QuangHop-dev/MiniSoC_integrated_Kyber_cryptographic_Accelerator/docs/Poster_DoAn.pdf

Work | Mode | Area | Freq. [MHz] | Key/Enc/Dec Time [us] | ADP [x10⁶ ]
LUT | FF | BRAM | DSP | ENS
[1] | Enc. | 80K | - | 200.5 | 54 | 158K | 155 | - / 316 / 444 | - /21/43.3
| Dec. | 202k | - | 202 | 354 | 217K
[2] | Enc. | 4.8K | 3K | 2.5 | 0 | 1885 | 244 | 278/ 416/ 552 | 0.54/ 0.78 /1.07
| Key.& Dec. | 4.9K | 3K | 2.5 | 0 | 1942
[3] | Key.& Enc.& Dec. | 5K | 2K | 6.5 | 2 | 2791 | 258 | 4593/ 4944/ 4691 | 12.8/ 13.8 /13.1
[4] | | 18K | 5K | 15 | 6 | 8540 | 115 | 34.8/ 60.9/ 86.9 | 0.30/ 0.52 /0.74
This Work | | 19K | 8K | 5 | 0 | 7321 | 167 | 46.7 / 60.1 / 82.4 | 0.34/ 0.44 /0.60

## 2. MỤC TIÊU & CƠ SỞ

# THIẾT KẾ VÀ ĐÁNH GIÁ PHẦN CỨNG TĂNG TỐC THUẬT TOÁN MẬT MÃ HẬU LƯỢNG TỬ CRYSTALS-KYBER TÍCH HỢP

# TRÊN VI ĐIỀU KHIỂN LÕI RISC-V

1. TÓM TẮT / ĐẶT VẤN ĐỀ | 5. KIỂM CHỨNG & KẾT QUẢ THỰC NGHIỆM

## 4. KIẾN TRÚC BỘ TĂNG TỐC CRYSTALS-KYBER

Module Simulation

## 6. KẾT LUẬN & HƯỚNG PHÁT TRIỂN

Controller

Comparator

Hash Unit Buffer Input | Buffer Output
Keccak
State

Keccak-f1600

θ | ρ | π | X

seed

rd/we

verify

start

done

mode

busy

din
ready

dout
addr

Memory Bank

Single Port RAM 0

Single Port RAM 1

Single Port RAM 2

Compress

Compress_u10

Compress_v4

Decompress

Decompress_u10

Decompress_v4

ROM Zeta

Barrett
Reduce

Barrett
Reduce

RAM0

RAM1

Basemul

Pointwise Multiply Accumulate

Sampling Unit

Matrix Sampler

CBD Sampler

Single Port RAM 3

Decode

Decode1

Decode12

Encode1

Encode12

Encode

Dual Port
RAM

Single Port
RAM

Unified
Add/sub

Unified
Add/sub

Unified Add/Sub mod q

H(pk),
ss

c1,
c2

c1,
c2

c1,
c2

seed

H(c),
H(c

digest

Dual Port
RAM 0

Dual Port
RAM 1

BFU

ROM Twidle

ADD_GEN | Control Unit

NTT/INTT

| s, e, r

t^, s^

A,
AT

m1

t'

e1, e2

pko, mo | mo

rho,
sigma,
K, rc | A, AT ski , pki , mi

sko,
pko,
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
r^, s^, e^

u

v

u,
v
Module độc lập mỗi chế độ riêng biệt | Module chia sẻ dùng chung cho ba chế độ

### Chú thích tên các khối

## 9. TÀI LIỆU THAM KHẢO

[1] Wu-Yiming-Huang, Miaoqing-Huang, Zhongkui-Lei and Jiaxuan, "A Pure Hardware Implementation of CRYSTALS-KYBER PQC Algorithm through Resource Reuse," IEICE Electronics Express, vol. advpub, p. 17.2020023, 2020.
[2] He-Ma-Shiyang, Hui-Li, Fenghua-Li and Ruhui, "A lightweight hardware implementation of CRYSTALS-Kyber," Journal of Information and Intelligence, vol. 2, no. 2, 949-7159, p. 2, 2024.
[3] Arpan-Jati, Naina-Gupta, Anupam-Chattopadhyay and Kumar-Sanadhya-Somitra, "A Configurable CRYSTALS-Kyber Hardware Implementation with Side-Channel Protection," ACM Trans. Embed. Comput. Syst., vol. 23, no. 1539-9087.
[4] Bisheh-Niasar-Mojtaba, Azarderakhsh-Reza and Mozaffari-Kermani-Mehran, "Instruction-Set Accelerated Implementation of CRYSTALS-Kyber,

" IEEE Transactions on Circuits and Systems I: Regular Papers, vol. 68, no. 11, pp. 4648-4659, 2021.

- Sự phát triển của máy tính lượng tử đang đe doạ các hệ mật mã công khai truyền thống như RSA hay ECC.
- CRYSTALS-Kyber là thuật toán cho trao đổi khoá bí mật đã được NIST chuẩn hoá và đang được cộng đồng học thuật liên tục tối ưu và hiện thực phần cứng
- Cần một kiến trúc phần cứng có hiệu năng cao, nhưng tiêu thụ tài nguyên hợp lý và phù hợp cho hệ thống nhúng.

Dựa trên thuật toán CRYSTALS-Kyber (ML-KEM).
Dựa trên toán học Mạng lưới (Lattice-based) và bài toán MLWE trên vành đa thức đồng dư.
Kiến thức về vi điều khiển và hệ nhúng.

## 3. KIẾN TRÚC VI ĐIỀU KHIỂN

Model C | Full SoC Simulation | FPGA Validation

QUY TRÌNH KIỂM CHỨNG

THỰC NGHIỆM TRÊN FPGA ZCU102

KeyGen | Decaps
- Chu kỳ: 7.785
- Kết quả khớp C-REF
- Chu kỳ: 10.025
- Kết quả khớp C-REF
- Chu kỳ: 13.743
- Kết quả khớp C-REF

Encaps

## Wishbone Bus

### RISC-V RV32I

IMEM (16KB)
0x00000-0x0FFFF

SRAM (16KB)
0x10000-0x1FFFF

TIMER
0x60000-0x6FFFF

I2C
0x40000-0x4FFFF

### UART

0x70000-0x7FFFF

GPIO0 / GPIO1
0x20000-0x2FFFF
0x30000-0x3FFFF

### Kyber Accelerator

0x80000-0x8FFFF

Interrupt Controller
0x50000-0x5FFFF

Interrupt
Event

### CƠ SỞ LÝ THUYẾT

### MỤC TIÊU

Thiết kế bộ tăng tốc có khả năng chia sẻ module và thực hiện các chế độ trên 1 phần cứng duy nhất.

Tích hợp bộ tăng tốc vào hệ thống vi điều khiển dùng CPU RISC-V RV32I.

Kiểm chứng bằng mô hình tham chiếu C, mô phỏng và thực nghiệm FPGA.

Hash Unit: băm dữ liệu.

Sampling Unit: sinh ma
trận và vector (CBD).

NTT/INTT: biến đổi số học.

PWMA: nhân-tích điểm.

Unified Add/Sub:
cộng/trừ modulo q.

Compress/Decompress/
Encode/Decode: nén, giải
nén, mã hoá, giải mã.

Comparator: so sánh kết
quả mã hoá lại ở Decaps.

TRƯỜNG ĐẠI HỌC CÔNG NGHỆ KỸ THUẬT

THÀNH PHỐ HỒ CHÍ MINH

KHOA ĐIỆN – ĐIỆN TỬ

BỘ MÔN KỸ THUẬT MÁY TÍNH – VIỄN THÔNG

# THIẾT KẾ VÀ ĐÁNH GIÁ PHẦN CỨNG TĂNG TỐC THUẬT TOÁN MẬT MÃ HẬU LƯỢNG TỬ CRYSTALS-KYBER TÍCH HỢP

# TRÊN VI ĐIỀU KHIỂN LÕI RISC-V

### GVHD:

### PGS.TS. Đỗ Duy Tân

### SVTH:

Phạm Quang Hợp | – 22119178
Đặng Vĩnh Tiến | – 22119239

Đã thiết kế và tích hợp được bộ tăng tốc CRYSTALS-Kyber vào hệ thống vi điều khiển và demo thành công trên FPGA.

Kết quả kiểm chứng cho thấy đầu ra khớp với kết quả từ phần mềm tham chiếu qua Known-Answer-Test (KAT).

Bảng so sánh kết quả đề tài với các nghiên cứu khác

Cơ bản, bộ tăng tốc đạt được sự cân bằng giữa hiệu năng và tài nguyên, vượt qua một số đề tài cùng cách tiếp cận khác.

### Hướng phát triển

- Tiếp tục tối ưu các khối lớn Hash Core, NTT giảm LUT/FF và tăng tần số hoạt động. Tích hợp khối TRNG để hoàn chỉnh bộ tăng tốc.
- Mở rộng môi trường kiểm thử với UVM, assertion để tự động bắt lỗi, và kiểm soát độ bao phủ code và chức năng phần cứng.
- Chuẩn hoá hệ thống theo FIPS-203, và mở rộng hỗ trợ hai mức bảo mật cao hơn ML-KEM-768 và 1024. Từ đó, tiến tới triển khai ASIC.

## 7. THÔNG SỐ HIỆN THỰC TRÊN FPGA

Fmax Implement

# 190 MHz

Tần số vận hành
chọn tại

# 167 MHz

Công suất toàn
hệ thống
1.326 W

WNS: 0.192 ns

WHS: 0.014 ns
