QuangHop-dev/MiniSoC_integrated_Kyber_cryptographic_Accelerator/kyber/ref/params.h

#ifndef PARAMS_H
#define PARAMS_H

#ifndef KYBER_K
#define KYBER_K 2	/* Kyber-512 default for this project */
#endif


/* Don't change parameters below this line */
#if   (KYBER_K == 2)
#define KYBER_NAMESPACE(s) pqcrystals_kyber512_ref_##s
#elif (KYBER_K == 3)
#define KYBER_NAMESPACE(s) pqcrystals_kyber768_ref_##s
#elif (KYBER_K == 4)
#define KYBER_NAMESPACE(s) pqcrystals_kyber1024_ref_##s
#else
#error "KYBER_K must be in {2,3,4}"
#endif

#define KYBER_N 256
#define KYBER_Q 3329

#define KYBER_SYMBYTES 32   /* size in bytes of hashes, and seeds */
#define KYBER_SSBYTES  32   /* size in bytes of shared key */

#define KYBER_POLYBYTES		384
#define KYBER_POLYVECBYTES	(KYBER_K * KYBER_POLYBYTES)

#if KYBER_K == 2
#define KYBER_ETA1 3
#define KYBER_POLYCOMPRESSEDBYTES    128
#define KYBER_POLYVECCOMPRESSEDBYTES (KYBER_K * 320)
#elif KYBER_K == 3
#define KYBER_ETA1 2
#define KYBER_POLYCOMPRESSEDBYTES    128
#define KYBER_POLYVECCOMPRESSEDBYTES (KYBER_K * 320)
#elif KYBER_K == 4
#define KYBER_ETA1 2
#define KYBER_POLYCOMPRESSEDBYTES    160
#define KYBER_POLYVECCOMPRESSEDBYTES (KYBER_K * 352)
#endif

#define KYBER_ETA2 2

#define KYBER_INDCPA_MSGBYTES       (KYBER_SYMBYTES)
#define KYBER_INDCPA_PUBLICKEYBYTES (KYBER_POLYVECBYTES + KYBER_SYMBYTES)
#define KYBER_INDCPA_SECRETKEYBYTES (KYBER_POLYVECBYTES)
#define KYBER_INDCPA_BYTES          (KYBER_POLYVECCOMPRESSEDBYTES + KYBER_POLYCOMPRESSEDBYTES)

#define KYBER_PUBLICKEYBYTES  (KYBER_INDCPA_PUBLICKEYBYTES)
/* 32 bytes of additional space to save H(pk) */
#define KYBER_SECRETKEYBYTES  (KYBER_INDCPA_SECRETKEYBYTES + KYBER_INDCPA_PUBLICKEYBYTES + 2*KYBER_SYMBYTES)
#define KYBER_CIPHERTEXTBYTES (KYBER_INDCPA_BYTES)

#endif
