QuangHop-dev/MiniSoC_integrated_Kyber_cryptographic_Accelerator/rtl/kyber/kyber_twiddle_rom.v

`timescale 1ns/1ps

// -----------------------------------------------------------------------------
// kyber_twiddle_rom
// Kyber512 RTL source. Comments and unused debug-only code were removed for a
// synthesis-oriented release build.
// -----------------------------------------------------------------------------

module kyber_twiddle_rom #(
    parameter USE_PWMA = 1'b0
)(
    input  wire        clk,
    input  wire [6:0]  addr,
    output reg  signed [15:0] dout
);

    generate
        if (USE_PWMA) begin : g_pwma_rom
            always @(posedge clk) begin
                case (addr)
                7'd0: dout <= 16'hFBEC;
                7'd1: dout <= 16'hFD0A;
                7'd2: dout <= 16'hFE99;
                7'd3: dout <= 16'hFA13;
                7'd4: dout <= 16'h05D5;
                7'd5: dout <= 16'h058E;
                7'd6: dout <= 16'h011F;
                7'd7: dout <= 16'h00CA;
                7'd8: dout <= 16'hFF55;
                7'd9: dout <= 16'h026E;
                7'd10: dout <= 16'h0629;
                7'd11: dout <= 16'h00B6;
                7'd12: dout <= 16'h03C2;
                7'd13: dout <= 16'hFB4E;
                7'd14: dout <= 16'hFA3E;
                7'd15: dout <= 16'h05BC;
                7'd16: dout <= 16'h023D;
                7'd17: dout <= 16'hFAD3;
                7'd18: dout <= 16'h0108;
                7'd19: dout <= 16'h017F;
                7'd20: dout <= 16'hFCC3;
                7'd21: dout <= 16'h05B2;
                7'd22: dout <= 16'hF9BE;
                7'd23: dout <= 16'hFF7E;
                7'd24: dout <= 16'hFD57;
                7'd25: dout <= 16'h03F9;
                7'd26: dout <= 16'h02DC;
                7'd27: dout <= 16'h0260;
                7'd28: dout <= 16'hF9FA;
                7'd29: dout <= 16'h019B;
                7'd30: dout <= 16'hFF33;
                7'd31: dout <= 16'hF9DD;
                7'd32: dout <= 16'h04C7;
                7'd33: dout <= 16'h028C;
                7'd34: dout <= 16'hFDD8;
                7'd35: dout <= 16'h03F7;
                7'd36: dout <= 16'hFAF3;
                7'd37: dout <= 16'h05D3;
                7'd38: dout <= 16'hFEE6;
                7'd39: dout <= 16'hF9F8;
                7'd40: dout <= 16'h0204;
                7'd41: dout <= 16'hFFF8;
                7'd42: dout <= 16'hFEC0;
                7'd43: dout <= 16'hFD66;
                7'd44: dout <= 16'hF9AE;
                7'd45: dout <= 16'hFB76;
                7'd46: dout <= 16'h007E;
                7'd47: dout <= 16'h05BD;
                7'd48: dout <= 16'hFCAB;
                7'd49: dout <= 16'hFFA6;
                7'd50: dout <= 16'hFEF1;
                7'd51: dout <= 16'h033E;
                7'd52: dout <= 16'h006B;
                7'd53: dout <= 16'hFA73;
                7'd54: dout <= 16'hFF09;
                7'd55: dout <= 16'hFC49;
                7'd56: dout <= 16'hFE72;
                7'd57: dout <= 16'h03C1;
                7'd58: dout <= 16'hFA1C;
                7'd59: dout <= 16'hFD2B;
                7'd60: dout <= 16'h01C0;
                7'd61: dout <= 16'hFBD7;
                7'd62: dout <= 16'h02A5;
                7'd63: dout <= 16'hFB05;
                7'd64: dout <= 16'hFBB1;
                7'd65: dout <= 16'h01AE;
                7'd66: dout <= 16'h022B;
                7'd67: dout <= 16'h034B;
                7'd68: dout <= 16'hFB1D;
                7'd69: dout <= 16'h0367;
                7'd70: dout <= 16'h060E;
                7'd71: dout <= 16'h0069;
                7'd72: dout <= 16'h01A6;
                7'd73: dout <= 16'h024B;
                7'd74: dout <= 16'h00B1;
                7'd75: dout <= 16'hFF15;
                7'd76: dout <= 16'hFEDD;
                7'd77: dout <= 16'hFE34;
                7'd78: dout <= 16'h0626;
                7'd79: dout <= 16'h0675;
                7'd80: dout <= 16'hFF0A;
                7'd81: dout <= 16'h030A;
                7'd82: dout <= 16'h0487;
                7'd83: dout <= 16'hFF6D;
                7'd84: dout <= 16'hFCF7;
                7'd85: dout <= 16'h05CB;
                7'd86: dout <= 16'hFDA6;
                7'd87: dout <= 16'h045F;
                7'd88: dout <= 16'hF9CA;
                7'd89: dout <= 16'h0284;
                7'd90: dout <= 16'hFC98;
                7'd91: dout <= 16'h015D;
                7'd92: dout <= 16'h01A2;
                7'd93: dout <= 16'h0149;
                7'd94: dout <= 16'hFF64;
                7'd95: dout <= 16'hFFB5;
                7'd96: dout <= 16'h0331;
                7'd97: dout <= 16'h0449;
                7'd98: dout <= 16'h025B;
                7'd99: dout <= 16'h0262;
                7'd100: dout <= 16'h052A;
                7'd101: dout <= 16'hFAFB;
                7'd102: dout <= 16'hFA47;
                7'd103: dout <= 16'h0180;
                7'd104: dout <= 16'hFB41;
                7'd105: dout <= 16'hFF78;
                7'd106: dout <= 16'h04C2;
                7'd107: dout <= 16'hFAC9;
                7'd108: dout <= 16'hFC96;
                7'd109: dout <= 16'h00DC;
                7'd110: dout <= 16'hFB5D;
                7'd111: dout <= 16'hF985;
                7'd112: dout <= 16'hFB5F;
                7'd113: dout <= 16'hFA06;
                7'd114: dout <= 16'hFB02;
                7'd115: dout <= 16'h031A;
                7'd116: dout <= 16'hFA1A;
                7'd117: dout <= 16'hFCAA;
                7'd118: dout <= 16'hFC9A;
                7'd119: dout <= 16'h01DE;
                7'd120: dout <= 16'hFF94;
                7'd121: dout <= 16'hFECC;
                7'd122: dout <= 16'h03E4;
                7'd123: dout <= 16'h03DF;
                7'd124: dout <= 16'h03BE;
                7'd125: dout <= 16'hFA4C;
                7'd126: dout <= 16'h05F2;
                7'd127: dout <= 16'h065C;
                    default: dout <= 16'sd0;
                endcase
            end
        end else begin : g_ntt_rom
            always @(posedge clk) begin
                case (addr)
                7'd0: dout <= 16'h08ED;
                7'd1: dout <= 16'h0A0B;
                7'd2: dout <= 16'h0B9A;
                7'd3: dout <= 16'h0714;
                7'd4: dout <= 16'h05D5;
                7'd5: dout <= 16'h058E;
                7'd6: dout <= 16'h011F;
                7'd7: dout <= 16'h00CA;
                7'd8: dout <= 16'h0C56;
                7'd9: dout <= 16'h026E;
                7'd10: dout <= 16'h0629;
                7'd11: dout <= 16'h00B6;
                7'd12: dout <= 16'h03C2;
                7'd13: dout <= 16'h084F;
                7'd14: dout <= 16'h073F;
                7'd15: dout <= 16'h05BC;
                7'd16: dout <= 16'h023D;
                7'd17: dout <= 16'h07D4;
                7'd18: dout <= 16'h0108;
                7'd19: dout <= 16'h017F;
                7'd20: dout <= 16'h09C4;
                7'd21: dout <= 16'h05B2;
                7'd22: dout <= 16'h06BF;
                7'd23: dout <= 16'h0C7F;
                7'd24: dout <= 16'h0A58;
                7'd25: dout <= 16'h03F9;
                7'd26: dout <= 16'h02DC;
                7'd27: dout <= 16'h0260;
                7'd28: dout <= 16'h06FB;
                7'd29: dout <= 16'h019B;
                7'd30: dout <= 16'h0C34;
                7'd31: dout <= 16'h06DE;
                7'd32: dout <= 16'h04C7;
                7'd33: dout <= 16'h028C;
                7'd34: dout <= 16'h0AD9;
                7'd35: dout <= 16'h03F7;
                7'd36: dout <= 16'h07F4;
                7'd37: dout <= 16'h05D3;
                7'd38: dout <= 16'h0BE7;
                7'd39: dout <= 16'h06F9;
                7'd40: dout <= 16'h0204;
                7'd41: dout <= 16'h0CF9;
                7'd42: dout <= 16'h0BC1;
                7'd43: dout <= 16'h0A67;
                7'd44: dout <= 16'h06AF;
                7'd45: dout <= 16'h0877;
                7'd46: dout <= 16'h007E;
                7'd47: dout <= 16'h05BD;
                7'd48: dout <= 16'h09AC;
                7'd49: dout <= 16'h0CA7;
                7'd50: dout <= 16'h0BF2;
                7'd51: dout <= 16'h033E;
                7'd52: dout <= 16'h006B;
                7'd53: dout <= 16'h0774;
                7'd54: dout <= 16'h0C0A;
                7'd55: dout <= 16'h094A;
                7'd56: dout <= 16'h0B73;
                7'd57: dout <= 16'h03C1;
                7'd58: dout <= 16'h071D;
                7'd59: dout <= 16'h0A2C;
                7'd60: dout <= 16'h01C0;
                7'd61: dout <= 16'h08D8;
                7'd62: dout <= 16'h02A5;
                7'd63: dout <= 16'h0806;
                7'd64: dout <= 16'h08B2;
                7'd65: dout <= 16'h01AE;
                7'd66: dout <= 16'h022B;
                7'd67: dout <= 16'h034B;
                7'd68: dout <= 16'h081E;
                7'd69: dout <= 16'h0367;
                7'd70: dout <= 16'h060E;
                7'd71: dout <= 16'h0069;
                7'd72: dout <= 16'h01A6;
                7'd73: dout <= 16'h024B;
                7'd74: dout <= 16'h00B1;
                7'd75: dout <= 16'h0C16;
                7'd76: dout <= 16'h0BDE;
                7'd77: dout <= 16'h0B35;
                7'd78: dout <= 16'h0626;
                7'd79: dout <= 16'h0675;
                7'd80: dout <= 16'h0C0B;
                7'd81: dout <= 16'h030A;
                7'd82: dout <= 16'h0487;
                7'd83: dout <= 16'h0C6E;
                7'd84: dout <= 16'h09F8;
                7'd85: dout <= 16'h05CB;
                7'd86: dout <= 16'h0AA7;
                7'd87: dout <= 16'h045F;
                7'd88: dout <= 16'h06CB;
                7'd89: dout <= 16'h0284;
                7'd90: dout <= 16'h0999;
                7'd91: dout <= 16'h015D;
                7'd92: dout <= 16'h01A2;
                7'd93: dout <= 16'h0149;
                7'd94: dout <= 16'h0C65;
                7'd95: dout <= 16'h0CB6;
                7'd96: dout <= 16'h0331;
                7'd97: dout <= 16'h0449;
                7'd98: dout <= 16'h025B;
                7'd99: dout <= 16'h0262;
                7'd100: dout <= 16'h052A;
                7'd101: dout <= 16'h07FC;
                7'd102: dout <= 16'h0748;
                7'd103: dout <= 16'h0180;
                7'd104: dout <= 16'h0842;
                7'd105: dout <= 16'h0C79;
                7'd106: dout <= 16'h04C2;
                7'd107: dout <= 16'h07CA;
                7'd108: dout <= 16'h0997;
                7'd109: dout <= 16'h00DC;
                7'd110: dout <= 16'h085E;
                7'd111: dout <= 16'h0686;
                7'd112: dout <= 16'h0860;
                7'd113: dout <= 16'h0707;
                7'd114: dout <= 16'h0803;
                7'd115: dout <= 16'h031A;
                7'd116: dout <= 16'h071B;
                7'd117: dout <= 16'h09AB;
                7'd118: dout <= 16'h099B;
                7'd119: dout <= 16'h01DE;
                7'd120: dout <= 16'h0C95;
                7'd121: dout <= 16'h0BCD;
                7'd122: dout <= 16'h03E4;
                7'd123: dout <= 16'h03DF;
                7'd124: dout <= 16'h03BE;
                7'd125: dout <= 16'h074D;
                7'd126: dout <= 16'h05F2;
                7'd127: dout <= 16'h065C;
                    default: dout <= 16'sd0;
                endcase
            end
        end
    endgenerate

endmodule
