QuangHop-dev/MiniSoC_integrated_Kyber_cryptographic_Accelerator/sw/include/soc_mmio.h

#ifndef SOC_MMIO_H
#define SOC_MMIO_H

#include <stdint.h>
#include <stddef.h>

static inline uint32_t mmio_read32(uint32_t addr)
{
    return *(volatile uint32_t *)(uintptr_t)addr;
}

static inline void mmio_write32(uint32_t addr, uint32_t value)
{
    *(volatile uint32_t *)(uintptr_t)addr = value;
}

static inline uint8_t mmio_read8(uint32_t addr)
{
    return *(volatile uint8_t *)(uintptr_t)addr;
}

static inline void mmio_write8(uint32_t addr, uint8_t value)
{
    *(volatile uint8_t *)(uintptr_t)addr = value;
}

static inline void mmio_barrier(void)
{
    __asm__ volatile ("" ::: "memory");
}

#endif
