QuangHop-dev/MiniSoC_integrated_Kyber_cryptographic_Accelerator/sw/apps/full_demo/main.c

#include <stdint.h>
#include <stddef.h>

#include "gpio.h"
#include "irq.h"
#include "kyber.h"
#include "kyber_demo_ref.h"
#include "lcd_i2c.h"
#include "pic.h"
#include "soc_memory_map.h"
#include "soc_platform.h"
#include "timer.h"
#include "uart.h"

#define LCD_ADDRESS 0x27u
#define LCD_COLS    20u

#define EV_DIP0_LED_TIMER (1u << 0)
#define EV_DIP1_LCD_TOGGLE (1u << 1)
#define EV_DIP2_UART_MSG  (1u << 2)
#define EV_DIP3_RESET     (1u << 3)
#define EV_DIP4_KEYGEN    (1u << 4)
#define EV_DIP5_ENCAPS    (1u << 5)
#define EV_DIP6_DECAPS    (1u << 6)
#define EV_DIP7_DEBUG     (1u << 7)
#define EV_EXT0_LED_BLINK (1u << 8)
#define EV_EXT1_LED_SWEEP (1u << 9)

#define DIP_STATE_MASK    (EV_DIP0_LED_TIMER | EV_DIP1_LCD_TOGGLE | EV_DIP7_DEBUG)
#define DIP_ACTION_MASK   (EV_DIP2_UART_MSG | EV_DIP3_RESET | EV_DIP4_KEYGEN | \
                           EV_DIP5_ENCAPS | EV_DIP6_DECAPS)
#define EXT_EVENT_MASK    (EV_EXT0_LED_BLINK | EV_EXT1_LED_SWEEP)
#define DIP_DEBOUNCE_LOOPS 800000u
#define LED_BLINK_LOOPS   2500000u
#define DIP_ACTIVE_LOW    0u

extern int memcmp(const void *a, const void *b, size_t n);
extern void *memcpy(void *dst, const void *src, size_t n);

static lcd_i2c_t lcd;
static uint8_t lcd_ok;
static uint8_t lcd_enabled;
static uint8_t led_timer_run;
static uint8_t debug_mode;
static uint8_t have_keypair;
static uint8_t have_capsule;

static volatile uint32_t irq_events;
static volatile uint32_t timer_irq_count;
static volatile uint32_t gpio_irq_count;
static volatile uint32_t ext0_irq_count;
static volatile uint32_t ext1_irq_count;
static volatile uint32_t led_counter;
static volatile uint8_t dip_sample_request;
static volatile uint32_t pic_enable_mask;
static uint32_t dip_shadow;

static uint8_t pk[KYBER_PK_BYTES];
static uint8_t sk[KYBER_SK_BYTES];
static uint8_t ct[KYBER_CT_BYTES];
static uint8_t ss_enc[KYBER_SS_BYTES];
static uint8_t ss_dec[KYBER_SS_BYTES];
static uint8_t ss_bad[KYBER_SS_BYTES];
static uint8_t seed_keygen[KYBER_SEED_BYTES];
static uint8_t seed_encaps[KYBER_SEED_BYTES];

static void dip_debounce_delay(void)
{
    volatile uint32_t i;

    for (i = 0u; i < DIP_DEBOUNCE_LOOPS; i++) {
    }
}

static void led_blink_delay(void)
{
    volatile uint32_t i;

    for (i = 0u; i < LED_BLINK_LOOPS; i++) {
    }
}

static uint32_t dip_active_mask(uint32_t raw)
{
    raw &= 0xffu;
#if DIP_ACTIVE_LOW
    raw = (~raw) & 0xffu;
#endif
    return raw;
}

static void uart_put_u32_dec(uint32_t value)
{
    char buf[11];
    int i = 0;

    if (value == 0u) {
        uart_putc(SOC_UART_BASE, '0');
        return;
    }

    while ((value != 0u) && (i < 10)) {
        buf[i++] = (char)('0' + (value % 10u));
        value /= 10u;
    }

    while (i > 0)
        uart_putc(SOC_UART_BASE, buf[--i]);
}

static void uart_put_hex_byte(uint8_t value)
{
    static const char hex[] = "0123456789abcdef";

    uart_putc(SOC_UART_BASE, hex[(value >> 4) & 0x0fu]);
    uart_putc(SOC_UART_BASE, hex[value & 0x0fu]);
}

static void uart_dump_bytes(const char *name, const uint8_t *buf, size_t len)
{
    size_t i;

    uart_puts(SOC_UART_BASE, "----- ");
    uart_puts(SOC_UART_BASE, name);
    uart_puts(SOC_UART_BASE, " len=");
    uart_put_u32_dec((uint32_t)len);
    uart_puts(SOC_UART_BASE, " -----\n");

    for (i = 0u; i < len; i++) {
        uart_put_hex_byte(buf[i]);
        if (((i + 1u) % 32u) == 0u)
            uart_puts(SOC_UART_BASE, "\n");
    }

    if ((len % 32u) != 0u)
        uart_puts(SOC_UART_BASE, "\n");
    uart_puts(SOC_UART_BASE, "\n");
}
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
