QuangHop-dev/MiniSoC_integrated_Kyber_cryptographic_Accelerator/(commit log)

2026-07-08 FPGA flow
2026-07-08 scripts for flow
